ZB45/LaosCNC/z_axis.png

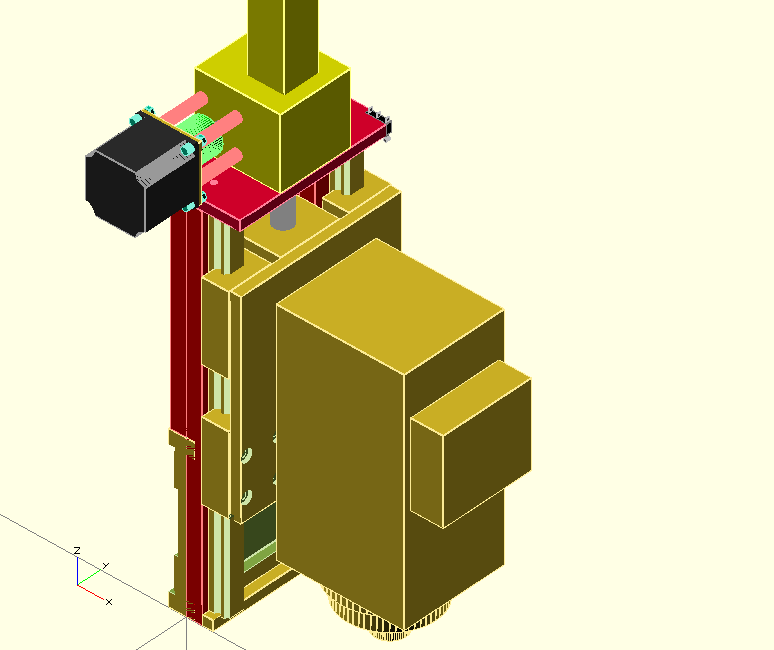
z_axis.png
