ZB45/LaosCNC/z_axis_materials.txt

materialenlijst Z-as
====================
metaalwinkel.nl
15x40mm staf alu
    356mm
    356mm
    202mm
    202mm
15x10mm staf alu
    154mm
10mm plaat alu
    80x154mm
    194x154mm
    60x60mm
    56x56mm (verloop nema23 motor, optioneel)
4 x lange moer, Mx, 50mm lang
draadeind Mx, stukjes op maat knippen, of lange bout

damencnc.com
1 x C41/47-C-SB-P-ER20-2.0KW-18000RPM 
1 x 220v: VFD022E21A 1x220V->3x220V 2.2KW & Keypad
2 x HIWIN Profile Rails HG20R, l=356mm
4 x HGH-20CA HIWIN Carriage HGH "Compact type"
1 x HUB ShaftCoupler DCNC-D32-L32_B6.35
1 x SPIDER DCNC-D32-L32 (B-green)
1 x HUB ShaftCoupler DCNC-D32-L32_B10.00

boutjes etc:
4 x inbus M6x15 // steunen aan x-as
6 x inbus M6x20 verzonken// verticale steunen aan elkaar
4 x inbus M6x25 // top plaat op steunen
4 x verzonken inbus M8x20 // spindle op top plaat (ondersteboven)
4 x stukje draadeind M5 // nema 17 connector
4 x lange moer M5x50 // op draadeind M5
4 x verzonken M5x25 // in draadeind M5 / nema_gasket
4 x inbus M5x12 // in NEMA23 motor
4 x moer M5 // NEMA23 motor
12 x inbus M6x15 verzonken // in rails 
16 x inbus M6x15 verzonken // in carts
2 x inbus M6x20 // in spindleconn
4 x inbus M6x20 // motor op plaat

missende (nog te bestellen) onderdelen voor z-axis-bouw:
* verzonken inbus schroeven
* lange moeren 50mm
* freesjes voor alu-freeswerk?

====================
Nieuwe onderdelenlijst

x_montageplt    // montageplaat op x-as. Is er. Er zijn sleuven in gefreesd
                // zodat de zsupport er in valt
zsupport (2x)   // rechtop staande alu-balkjes van 15x40
                // links en rechts zijn in spiegelbeeld!
        * M6 gaten voor de haakse support boren, met verzonken kop aan de voorkant
        * M6 gaten voor de rails boren, met verzonken op aan de achterkant
        * GETAPTE M6 gaten voor de bevestiging aan x_montageplaat boren. 
            Deze moeten boven en onder zitten
        * M5 gaten boren voor bevestiging aan x_montageplaat, midden (2x)
            daarna: FREZEN in de vorm van een zeskantkop
        * GETAPT M4 gat voor stopblock
        * M6 kopse kant: middenin gat tappen voor topplate, 20 diep
zsupport2 (2x) 
        * GETAPTE M6 gaten op 15mm zijde, voor bevestiging aan zsupport 
        * GETAPT M6 gat kopse kant middenin. 10mm diep?
stopblock
        * M4 gaten met verzonken inbus kop (2x)
zrails
        * inkorten (beide kanten?) zodat hij past (2x)
topplate
        * prototype van hout!
        * M8 4 gaten boren
        * M6 4 gaten boren
        * heel groot gat frezen voor doorsteek
zcarts // kunnen zo op de rails geschoven worden
z_montageplaat
        * veel gaten M6 tbv hfmotor
        * M6 (16x) met verzonken kop tbv zcarts
        * M5 (4x) met verzonken kop tbv spindleconn();
hfmotor     // kant en klare motor
spindleconn // dit is een ingewikkeld ding. maken uit staal!
motorkoppeling: past hij bij de motor die ik wil gebruiken?
verloopje nema17->23: maken of kopen, of heel zware nema17 gebruiken 
stappenmotor nema17 of nema23
2 x eindstop

Bouten, moeren, ringen
----------------------
8 x M4 inbus (lengte?) tbv. x-carts in x_montageplt
4 x M6 inbus 20-25mm tbv zsupport in x_montageplt
4 x M5 zeskantbout van zsupport naar x_montageplt
4 x M5 moer
4 x M5 ring
6 x M6 30mm inbus
2 x M4x20 inbus
12 x M6x20-25 inbus
2 x M6x30 inbus
2 x M6x20 inbus
4 x M8x30 inbus??? in de spindle zitten al bouten, maar zijn ze lang genoeg?
16 x M6x20 inbus
4 x M6x20 inbus
4 x M5x25 inbus
4 x M5 ringetje
4 x M5 moer
4 x M5 afstandhouder (50mm)
4 x M5 draadeind 40mm
4 x M5x12 inbus
4 x M5 moer
4 x M5 ring
