ZB45/LaosCNC/x_rails.dxf

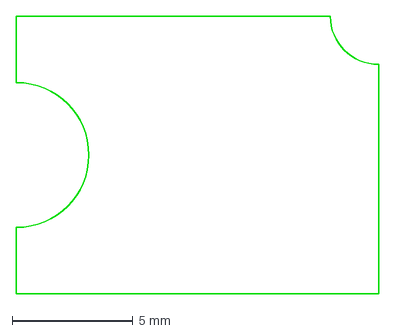
[picture p2: CAD file, 2013-01-20]
x_rails.dxf
15.0 x 11.5 mm
