ZB45/LaosCNC/x_gliderblock.dxf

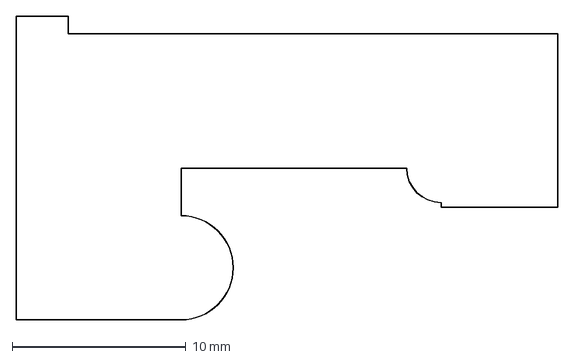
[picture p3: CAD file, 2013-01-20]
x_gliderblock.dxf
31.2 x 17.5 mm
