ZB45/LaosCNC/extrusie-doorsnee.dxf

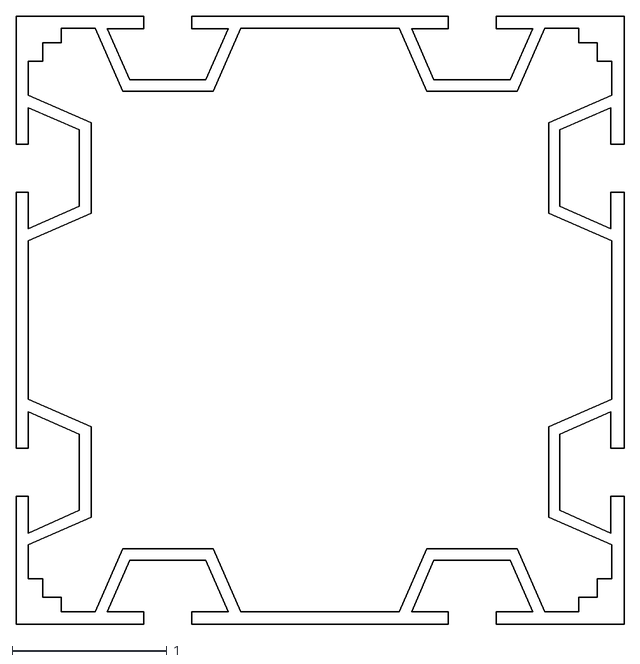
[picture p4: CAD file, 2013-01-13]
extrusie-doorsnee.dxf
3.93 x 3.93
