ZB45/LaosCNC/R30.dxf

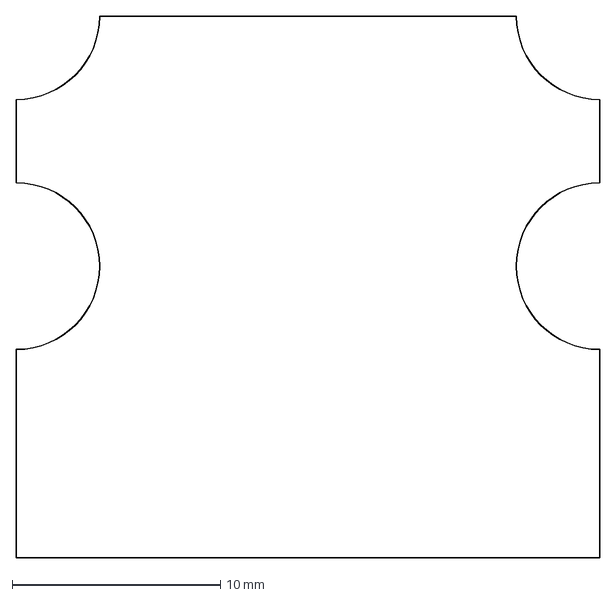
[picture p5: CAD file, 2013-01-13]
R30.dxf
28.0 x 26.0 mm
