ZB45/LaosCNC/(list of files, cad)

Other CAD files:
x-as.dxf
x_balk.dxf
