ZB45/LaosCNC/(commit log)

2013-01-13 originele tafel + R30 profiel
    [R30.dxf, R30.scad, extrusie-doorsnee.dxf, main.scad, tafel.scad]
2013-01-13 added rackdrive.scad (made by peter)
    [rackdrive.scad]
2013-01-18 start design x-axis and rack
    [Rack_and_Pinion.scad, main.scad, x_axis.scad]
2013-01-20 work on x-axis
    [R30.scad, hoeklijn.scad, main.scad, tafel.scad, x-as.dxf, x_axis.scad, x_balk.dxf, x_gliderblock.dxf]
2013-01-21 x-axis more complete now
    [main.scad, x_axis.scad, x_kogelomloop.scad, x_montageplt.dxf, x_montageplt.scad]
2013-01-23 more on x and z axis
    [main.scad, x_axis.scad, x_kogelomloop.scad, x_stand.scad, z_axis.scad]
2013-01-23 unfinished changes to z_axis
    [z_axis.scad]
2013-01-23 z axis improvements
    [z_axis.scad]
2013-01-23 z-axis with motor
    [z_axis.scad]
2013-01-24 z-axis ready
    [NEMA17-to-27-adapter.scad, z_axis.scad]
2013-01-24 nog meer boutjes
    [z_axis.scad]
2013-01-26 wider design for z_axis, almost finished
    [endstop.scad, z_axis.scad]
2013-01-28 z_axis after ordering parts
    [x-as.dxf, x_axis.scad, z_axis.scad]
2013-03-15 small changes
    [Rack_and_Pinion.scad, x_axis.scad, z_axis.scad]
2013-04-24 z axis result
    [Rack_and_Pinion.scad, endstop.scad, tafel.scad, x_montageplt.scad, z_axis.scad]
2013-04-24 documentatie spindle
2013-04-25 improvements on x+y axis
    [Rack_and_Pinion.scad, main.scad, x_axis.scad, x_stand.scad]
